M4XG4RC1A/BastonUltrasonicoPortable_UnitedHands/Modelos 3D/Anexo2.STL

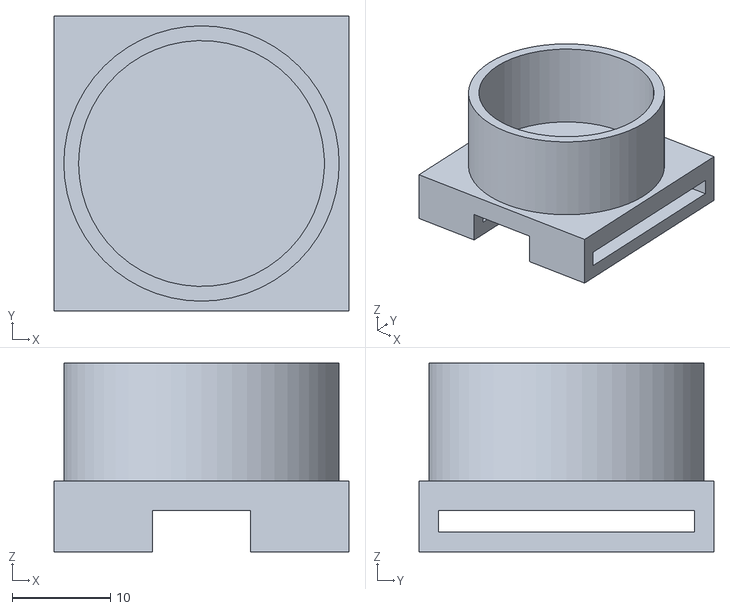
[picture p6: CAD file, 2021-07-22]
Modelos 3D/Anexo2.STL
30.0 x 30.0 x 19.2
