M4XG4RC1A/BastonUltrasonicoPortable_UnitedHands/Modelos 3D/Anexo1.STL

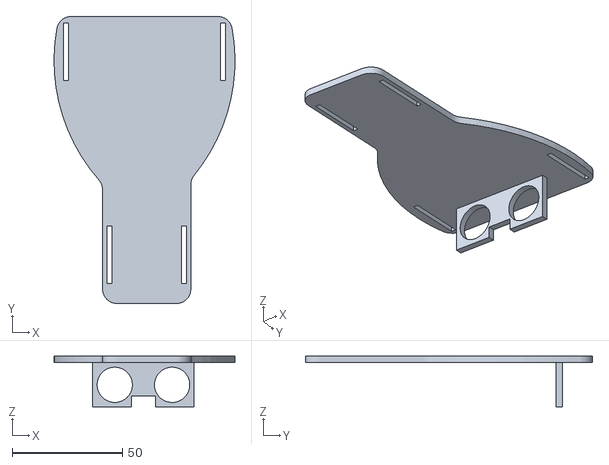
[picture p7: CAD file, 2021-07-22]
Modelos 3D/Anexo1.STL
82.0 x 130.0 x 23.0
