M4XG4RC1A/BastonUltrasonicoPortable_UnitedHands/(list of files, drawings)

Other design files:
Conexiones Electronicas/Proyecto1.fzz
